ronHartikka/leaf_inverter_rotation/docs/rotation_budget.md

# Rotation budget — the make-or-break question

The whole project turns on one inequality: with 3 loads sharing one inverter
one-at-a-time, the **sum of their duty cycles must stay well under 100%**. If it
doesn't, no rotation schedule can keep all three adequately powered.

## Measured so far

| Load | Running current | Duty cycle | Warmup (OFF)  | Status |
|---|---|---|---|---|
| Dorm fridge | ~0.68 A | ~50% | ~1.1 °F/min | done (test piece, worst case) |
| Chest freezer  | ~0.72 A | ~70% / **60.8%** | ~0.18 °F/min  | done — **flagged for replacement**; see the deployment measurement below |
| Kitchen fridge | ~0.75 A (meas.) | ~60% / **46.9% settled** | TBD (×2 compartments) | night baseline done; deployment measurement below |
| Furnace | TBD | TBD | TBD | later |

**Kitchen fridge — the duty figure swings 13 points on defrost timing [2026-09-28/29].**
A gap-free 17.6 h capture, 17 cycles, one complete defrost
(`firmware/esp32_ads1115_cycle_stats`; see `loads/kitchen_fridge.json`
`deployment_2026_09_28`).

- **Settled cycling 46.9%** (on 24.8, off 28.0 min, sd 0.8/1.6) — the quiet overnight
  state after recovery.
- **Whole capture 59.9%**, including one defrost and its 131 min recovery run at 94.9%
  duty.
- The July night baseline of ~59-60% matches the WHOLE-CAPTURE figure, which suggests
  that window contained a defrost as well.

**So this load has no single duty number.** Defrost fires on accumulated compressor
run-hours (7–50), making it a scheduling term rather than a constant — and the budget
has to treat it as one. Settled on/off (24.8/28.0) also differ from July's ~32/~21 in
opposite directions, so conditions differed too; the two are not mergeable.

**Chest freezer — DEPLOYMENT duty measured 60.8%, not 70% [2026-09-27/28].** A gap-free
13.2 h capture in the deployment location, undisturbed, 9 complete cycles
(`firmware/esp32_ads1115_cycle_stats`, see `loads/chest_freezer.json`
`deployment_cycle_2026_09_28`). Extraordinarily repeatable: **off-period sd 9 seconds**
across 8 intervals, duty sd 0.9%.

- **on 52.3 min, off 33.8 min, duty 60.8%** — against 26.6 / 11.1 / 70% from the
  warm-bench characterisation. Both measured; NOT the same situation.
- The table above now carries both figures. **Which one this budget should use is an open
  decision.** 60.8% materially changes the arithmetic — 3 × 60.8% = 182% rather than 210%,
  still far over budget, but the freezer is less dominant than recorded.
- **It is a PRE-DEFROST number.** Ron observed more frost than usual on 2026-09-26, and
  the doubled run times are consistent with reduced cooling capacity. The queued defrost
  experiment (`docs/todo.md`) uses this capture as its BEFORE half and may move the figure
  again. Settle the budget figure after that, not before.

**Kitchen fridge — night baseline measured [2026-07-21/22 fresh capture].**
~15 h continuous capture with the 3.5 A firmware; clean cycling, no false trips.
- Running current: variable-speed inverter — **~0.75 A steady** near setpoint,
  **~1.5 A during pulldown/recovery** (warm box, e.g. post-defrost).
- **Duty ~59-60%** over 11 h of overnight steady cycling (12 clean cycles: ON mean
  ~32 min, OFF mean ~21 min). Consistent with the 2026-07-19/20 shakedown's ~64%
  eyeball -> the fridge settles around ~60%.
- Freezer band ~-6 to ~+4-5 °F; food-safe throughout. (Per-compartment warmup rate
  + exact band: finalize after the daytime capture, on the full file.)
- Defrost characterized: ~29 min, ~1.8 A / 198 W, sensor-based adaptive. See
  loads/kitchen_fridge.json "defrost".
- STILL NIGHT-ONLY / "pre-stabilized": undisturbed, few door openings, night
  ambient. DAYTIME capture (running till 10pm 2026-07-22) will add the
  higher-duty, doors-open, warmer-ambient regime that reflects real use. Finalize
  day-vs-night duty + per-compartment thermal after that. ~60% is the night floor;
  daytime will likely be higher.

A ~60% fridge is freezer-territory duty and, on its own, hostile to a naive
3-load budget. But see "The real question" below — additive free-running duties
are NOT how this system will actually be scheduled.

## Where this stands
Dorm fridge (~50%) + chest freezer (~70%) already sum past 100% — but the dorm
fridge is a test piece and the freezer is being replaced, so neither is a final
deployment number. The real budget is: **kitchen fridge + replacement freezer +
furnace.** The fridge duty is the next input. A replacement freezer should land far
below 70% (the current unit's high duty is a low-charge/frost fault, not inherent to
chest freezers — its warmup rate proves the thermal mass is excellent).

Michigan outages are cold-weather events, so real-world duty runs below warm-bench
numbers — a tailwind, but don't rely on it to rescue a marginal budget.

## The real question — freezer duty UNDER INTERRUPTION is the gating unknown [2026-07-22]

The tempting arithmetic: fridge ~60% duty -> ~24 min/hr of free inverter time
(measured OFF windows 18-32 min, mean 21). Could the freezer live in that gap?
- Current (faulty) freezer ~70% duty needs ~42 min/hr -> takes ALL the offered gap
  and still falls behind. Doesn't fit.
- A healthy replacement (expected ~20-35%) needs ~12-21 min/hr -> the gap covers it
  with margin. Fits.
So the answer swings ENTIRELY on the replacement freezer's duty — a number we do
not have.

Do we have enough to answer confidently? NO. Three reasons, in priority order:
1. REPLACEMENT FREEZER NOT CHARACTERIZED. The current unit's ~70% is explicitly a
   low-charge/frost FAULT, not the deployment number. This is THE dominant unknown;
   the whole budget pivots on it.
2. FREE-RUNNING DUTY != DUTY UNDER INTERRUPTION. Duty measured under continuous
   power does not directly predict behavior when a box is force-cut for hours
   (recovery is deeper/longer, nonlinearly). Free-running 60%/70% are inputs to a
   guess, not the answer. Only measuring duty IN the interruption regime settles it.
3. REGIME MISMATCH. Intended use is HOURS-on / HOURS-off (not minute-scale
   gap-filling), and in the real system BOTH boxes get interrupted — the fridge will
   not free-run while the freezer sips its gaps. The clean "fridge runs / freezer
   fills gaps" picture does not hold in deployment.

=> NEXT REAL OBJECTIVE: characterize the REPLACEMENT freezer UNDER INTENTIONAL
   INTERRUPTION (simulate the hours-scale rotation blocks the system will actually
   run: power freezer alone, then freezer+fridge). Measuring duty in the deployed
   regime — not more free-running fridge data — is the single measurement that most
   moves the budget toward a confident yes/no. The fridge side is essentially done
   (~60% night baseline; daytime baseline in progress).
   REPLACEMENT FREEZER: not yet ordered (~2026-07-23), going ENERGY STAR for better
   insulation -> expect lower duty + slower warmup (favorable for the budget). Re-
   measure when it arrives; do NOT inherit the old (faulty ~70%) unit's numbers.

INTERIM CHEAP EXPERIMENT (before the freezer, on the fridge already on the rig):
the INTERRUPTION TEST (docs/interruption_test.md) — cut fridge power during a natural
off period for a swept Δt and see when it stays free vs costs recovery. Tests the
central "off-periods are stealable" hypothesis + whether power-cycling disrupts the
run-hours defrost schedule. Yields the max free off-window (a scheduler parameter).

PRACTICAL NOTE — DEFROST LOGIC [confirmed by SERVICE MANUAL + 2 observed defrosts,
2026-07-22]:
- Trigger = COMPRESSOR RUN-HOURS (not wall-clock, not power-on). Manual: defrost
  fires between 7-50 accumulated compressor run-hours, adaptive by door-open time
  (more door-open -> more frost -> sooner). After a true power restore: 4 run-hours.
- Duration terminates when the evaporator defrost SENSOR hits 50 F -> frost-load-
  dependent, ~30 min typical (our 2 defrosts) but up to a 2 h ceiling if heavily frosted.
- Load: ~198 W / ~1.8 A, compressor off, during the window.
Two consequences for the schedule:
  (1) run-hours basis => ROTATION STRETCHES the calendar defrost interval: an
      interrupted fridge accrues run-hours slower, so it defrosts less often per day
      than the ~daily seen at ~60% continuous duty. Favorable — spreads the load.
  (2) after a real outage/restore, the first defrost comes SOON (4 run-hours) => the
      first big fridge power-block after restore should budget a ~30 min defrost early.
Actionable takeaway: budget a recurring defrost window (~30 min typ, up to 2 h), and
expect one early in the first post-restore fridge block. Frequency scales with
door-open activity (daytime > undisturbed night).

ADAPTIVE TRIGGER CONFIRMED FROM DATA [3 defrosts by 2026-07-23]: integrated compressor
run-hours between defrosts were 15.0 (quiet overnight interval, 65% duty) then 8.0
(heavy dinner/evening door activity, 81% duty) -- the threshold slid 15->8 run-hours
toward the 7 h floor as door/frost increased, exactly the manual's "7-50 h by door-open
time." => MILD tailwind only (do NOT bank it): outage door use is somewhat lower, so
defrost is somewhat less frequent -- BUT the household still eats and cooks during
outages [Ron, 2026-07-23], so assume a MODEST reduction, not a large one; do not rely
on defrost being rare. Also: effective fridge duty for budgeting =
~59% steady cycling PLUS periodic defrost+recovery overhead (each defrost adds ~30 min
heater + ~2 h recovery run), which scales with defrost frequency i.e. with use.

## Rule of thumb
- 3 × 50% = 150% → impossible.
- 3 × 15–20% = 45–60% → feasible with margin.

Note ambient temperature with every duty-cycle observation; duty is strongly
ambient-dependent.
