ronHartikka/leaf_inverter_rotation/docs/prior_art_sketches.md

# Prior-art sketches — Nov 2024 to Mar 2025, outside the repo

Surveyed 2026-09-21. **23 Arduino sketches** sit in
`~/Documents/RetirementWork/Engineer/inverter/` on the Mac — the data directory, one
level above this repo — and **none of them are in version control**. They predate the
repo by about eighteen months and several of them are directly relevant to work now
being designed here.

They are NOT copied in, because **10 of the 23 have the live WiFi SSID and password
hard-coded** and this repo is public on GitHub. Anything moved in must first take
credentials from `firmware/shared/wifi_secrets.h` (git-ignored, template in
`wifi_secrets_example.h`).

## The ones that matter

| Sketch | Date | Why it matters |
|---|---|---|
| `continuous_ADS1115` | 2024-12-26 | Interrupt-paced ADS1115 sampling, 860 SPS |
| `nonblocking_ADS1115` | 2024-12-26 | `startADCReading` / `conversionComplete` shape |
| `timer_interrupt_esp32` | 2024-12-26 | ESP32 hardware-timer ISR |
| `rms_ac_with_filters_master` | 2025-01-02 | True-RMS with two-point calibration |
| `running_statistics_socket_server_2` | 2025-02-02 | The convergence: ISR sampling + RMS + socket |
| `esp32_acs712_ads1115` | 2025-03-08 | Bring-up sketch for the §7 perfboard node |
| `socket_server` | 2024-12-20 | ESP8266 — the only ESP8266 network code here |

## Worth reusing

**Interrupt-paced ADS1115 sampling.** `continuous_ADS1115` and
`running_statistics_socket_server_2` already have the correct non-blocking pattern:
`IRAM_ATTR` ISR on ALERT/RDY setting a `volatile bool`, `startADCReading(...,
continuous=true)`, `getLastConversionResults()` in the loop, `RATE_ADS1115_860SPS`.
This is what the ALERT/RDY line on GPIO16 exists for (`docs/mcu_inventory.md` §7).

**`RunningStatistics` from the Filters library.** `inputStats.sigma()` is AC RMS with
DC removed, which is the right measure for an AC current. Note what goes unused:
`inputStats.mean()` is already computing the DC offset — a **live zero** — and every one
of these sketches then ignores it and hard-codes `2.5`. Lesson #4's auto-zero wants
exactly that number.

**Two-point calibration.** `rms_ac_with_filters_master` computes
`Amps_TRMS = intercept + slope * sigma()`. That is the mechanism `mcu_inventory.md` §5
says is mandatory before any ADS1115 number can join the existing dataset.

## Do NOT reuse — the socket half is the wrong shape

Seven sketches implement a `WiFiServer` on port 80. Both of its properties are wrong
for this system:

- **Direction is backwards.** `docs/dual_logger_socket_ingest.md` §2 requires nodes to
  **dial out** to the logger, so the logger never needs to know a node's address and
  DHCP can move nodes freely. These wait to be connected to.
- **They block.** The pattern is `while (client.connected()) { while
  (client.available()>0) {...} delay(5); }`. While a client is connected the sampling
  loop never runs. That is §9's starvation failure by construction — the one measured on
  the RTD node at 41 samples in 122 s where 1 Hz should give ~122.

**Drop the NTP machinery too.** Node-side time is not wanted: §5 arrival-stamps every
line at the logger, and a node clock is a second clock (lesson #8).

The echo loops and the `while(a<9) client.write("a")` counters are demo scaffolding from
whatever tutorial these started as. Nothing to carry over.

## Flags

**The differential arrangement WORKED — it was not merely written.** Corrected
2026-09-23 from Ron's contemporaneous notes (`notes.odt` / `notes2.odt` / `Untitled
6.odt` in the data dir, same text in all three):

> got `continuous_ADS1115.ino` working at maximum rate: `RATE_ADS1115_860SPS`,
> configuration: `ADS1X15_REG_CONFIG_MUX_DIFF_2_3`, mode: `CONTINUOUS`
> attached signal generator 60 Hz, 0 VDC, 1VAC (rms). Got reasonable data to serial
> monitor

So differential AIN2/AIN3 at 860 SPS continuous ran and was **validated against a known
reference** in Dec 2024. What it validated is the ADC and the differential path: 0 VDC
offset means the generator drove the ADC inputs directly, NOT through the ACS712, so the
sensor-to-ADC arrangement is still unproven.

`running_statistics_socket_server_2` (Feb 2025) nonetheless runs
`ADS1X15_REG_CONFIG_MUX_SINGLE_0` with the DIFF_2_3 line commented out. **Why it was
switched back to single-ended is unrecorded.** Decide it deliberately; do not read the
comment-out as evidence that differential failed.

**The signal generator is a reusable asset here.** A known 60 Hz amplitude is exactly
what the §5 cross-calibration against the ACS712 + Arduino chain needs.

**Single-ended reads use a hard-coded 2.5 V zero**, with a commented-out `2.325` from
some earlier bench session sitting next to it — the drift lesson #4's auto-zero window
exists to catch.

## The intended architecture: statistics per POWER CYCLE

The same notes record the design Ron was working toward in Jan 2025, and it is better
than what shipped:

> But to measure at say 600 sps — ten times in each 60 Hz cycle — I don't want
> continuous? ... If 60 Hz sample, output stats for this 60 Hz cycle, reset stats

> Goal for 2 Jan 2025: ... sample window for RunningStatistics is **one power cycle**, if
> possible

One RMS value per 60 Hz cycle, statistics reset every cycle. That yields the **envelope**
of a start transient cycle by cycle, which is what surge work needs.

What actually shipped does the opposite. `running_statistics_socket_server_2` sets
`windowLength = 10/testFrequency` — a ~167 ms window smearing about ten cycles together,
which is precisely what hides a transient. The window values drift across the
collection: 0.8 s in `ACS712_Code_3`, 0.033 s in `rms_ac_with_filters_master`, 0.167 s in
the newest.

**The 50/60 Hz trap, already caught by Ron in the notes:** `ACS712_Code_3` ships
`testFrequency = 50` — a European default — and his note flags it, "Power line frequency
(not in USA, though)". Any sketch inheriting that constant computes its window against
the wrong line frequency.

## An opening on lesson #10

These sample at 860 SPS but keep only `sigma()` over a ~167 ms window, so peaks are
averaged away before anything records them. **A per-window max-hold on the raw samples
would cost nothing and would bound the chest freezer's inrush**, which lesson #10 says
is currently unmeasured and which `docs/jackery_300_plus.md` calls the single strongest
argument for a scope measurement.

At ~14 samples per 60 Hz cycle this still cannot give a true instantaneous peak —
lesson #10's conclusion is unchanged — but it would move that number from "unmeasured"
to "bounded", and unlike a scope it can sit for days waiting for a cold start.

## What this does NOT answer

`socket_server` proves basic ESP8266 connect works (`ESP8266WiFi.h`, `WiFi.begin`,
`WiFi.status`, `localIP`). It does **not** close the open item in
`docs/wifi_bridge_build.md`: nothing here does best-AP-by-signal, WiFi event handlers,
or BSSID logging, so the ESP32→ESP8266 translation of `docs/esp32_wifi_production.md`
is still unanswered.

## The board's purpose, and the one capture that survives

Ron's recollection (2026-09-21): the §7 perfboard node was built **to measure surges**,
with the furnace blower and the compressors as the targets. A large fan was measured
with it.

That capture still exists: `CoolTerm Capture (Untitled_0) 2025-03-09 11-46-54-590.txt`
in the data dir, 5426 samples, opening with `Getting single-ended readings from
AIN0..3` — the banner of `esp32_acs712_ads1115.ino`, dated the day before. Values are
volts (the sketch prints `volts0` raw).

| | volts | amps @ 100 mV/A |
|---|---|---|
| min | 1.47 | −8.0 |
| max | 3.06 | +7.9 |
| mean / median | 2.2698 / 2.27 | — |

The chain worked: a symmetric ±8 A peak AC waveform, sampled on the waveform itself
rather than as an RMS.

### Three findings from it, all blocking for surge work

**PROVENANCE (Ron, 2026-09-21): this capture was probably made with the BREADBOARD
version, which no longer exists.** The perfboard node "probably" carries the same
wiring, but that is recollection, not verification — it cannot be used to validate the
perfboard board. Practical consequence: **do not inherit the 2.27 V zero below.** A zero
belongs to a specific sensor on a specific supply, not to a design. Re-measure it on the
finished board. What survives is the *shape* of the finding, which is architectural.

**1. The measured zero is 2.27 V, not 2.5 V.** Every sketch computes
`(volts0 - 2.5) / 0.100`, so everything that chain ever reported carries a systematic
**−2.3 A** offset. The commented-out `2.325` sitting beside it was chasing the same
thing. And 2.27 V is **below the 2.3–2.7 V auto-zero window** in
`firmware/shared/current_sense.h` — lesson #4's sanity check would REJECT this sensor.
Resolve that before quoting any number off this board; `inputStats.mean()` already
computes a live zero and is being thrown away.

**2. `GAIN_ONE` clips at ~16 A, which is the wrong ceiling for surge work.** At
±4.096 V full scale against a 2.5 V zero, `(4.096 − 2.5) / 0.1 ≈ 16 A`. Lesson #10 says
the chest freezer's true inrush is unmeasured and likely well above the method-limited
~3.5 A, so GAIN_ONE risks truncating the very number the board exists to capture. Use
**`GAIN_TWOTHIRDS`** (±6.144 V), which several sketches carry commented out.

**TRAP — the gain comment is wrong in five sketches.** They read
`ads.setGain(GAIN_ONE);  // 2/3x gain +/- 6.144V`. The comment describes a DIFFERENT
gain than the code sets. Anyone reading it believes they have 6.144 V of range when
they have 4.096.

**2b. The ADS1115 is NOT ratiometric, and that is the real lesson here.** The ACS712's
zero is **Vcc/2 by design**, so a 2.27 V zero implies a sensor rail near **4.54 V** —
230 mV is far outside ACS712 offset tolerance, so this reads as a sagging supply, not a
quirky part. (Reasoned from the capture, not separately measured — mark it medium
confidence until the finished board is checked.)

The ADS1115 has an internal precision reference and its FSR settings are absolute volts,
which is why `computeVolts()` returns volts rather than a ratio. The rig's Arduino gets
supply cancellation **for free** because its ADC reference IS the 5 V rail the ACS712
runs on, so sag moves sensor and reference together. An ADS1115 throws that away: a
sagging sensor rail moves the zero AND the sensitivity, straight into the reading.

Two consequences:

- **§5's differential-against-Vcc/2 is not a refinement, it is the fix** — it cancels
  supply drift in hardware and restores what this architecture otherwise loses. The
  parked `readADC_Differential_2_3` code is the thing to revive.
- **The 9 V → 7805 supply concern gets sharper.** A battery-fed regulator sagging under
  ESP32 WiFi bursts does not merely risk corrupt reads; in single-ended mode it silently
  moves the calibration.

**CHECK ON THE BOARD:** how AIN2 and AIN3 are actually wired decides whether differential
mode is available as built. Add it to the continuity check in `mcu_inventory.md` §7.

**3. The capture is free-running and unpaced** — `Serial.println` in a bare loop, no
timestamps, no fixed rate. It gives amplitude only; a start transient cannot be told
from running current in it. That is exactly what the interrupt-paced 860 SPS path in
`continuous_ADS1115` fixes, and why the board should be finished on that path rather
than this one.

### Why the targets are the right ones

`loads/furnace.json` carries **every** electrical value at `confidence: low`, cube-law
derived, none measured — the blower is genuinely unmeasured rather than imprecise. And
the freezer compressor is lesson #10's open item. Both are the gap this board was built
for, and neither is served by the rig's 10 Hz / 100 ms-RMS chain.
