ronHartikka/leaf_inverter_rotation/analysis/coast_setting5_0727eve.png

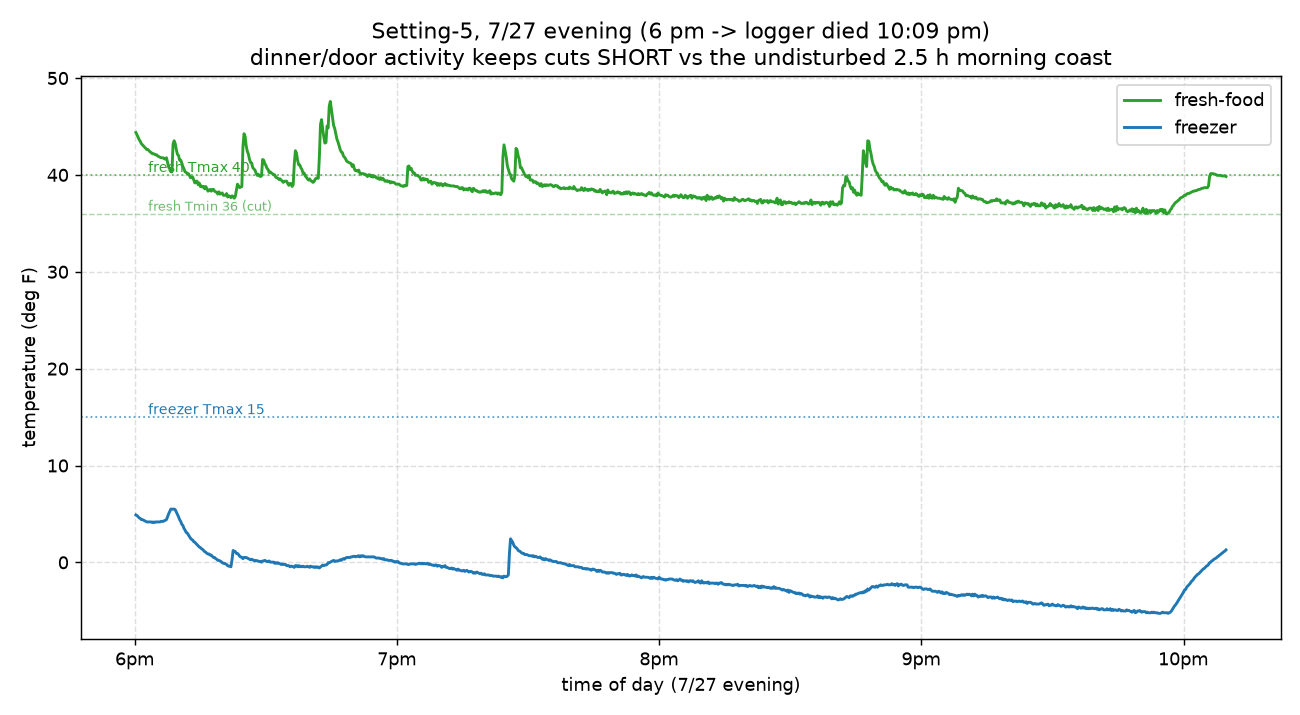
analysis/coast_setting5_0727eve.png
