ronHartikka/leaf_inverter_rotation/analysis/coast_setting5_0728.png

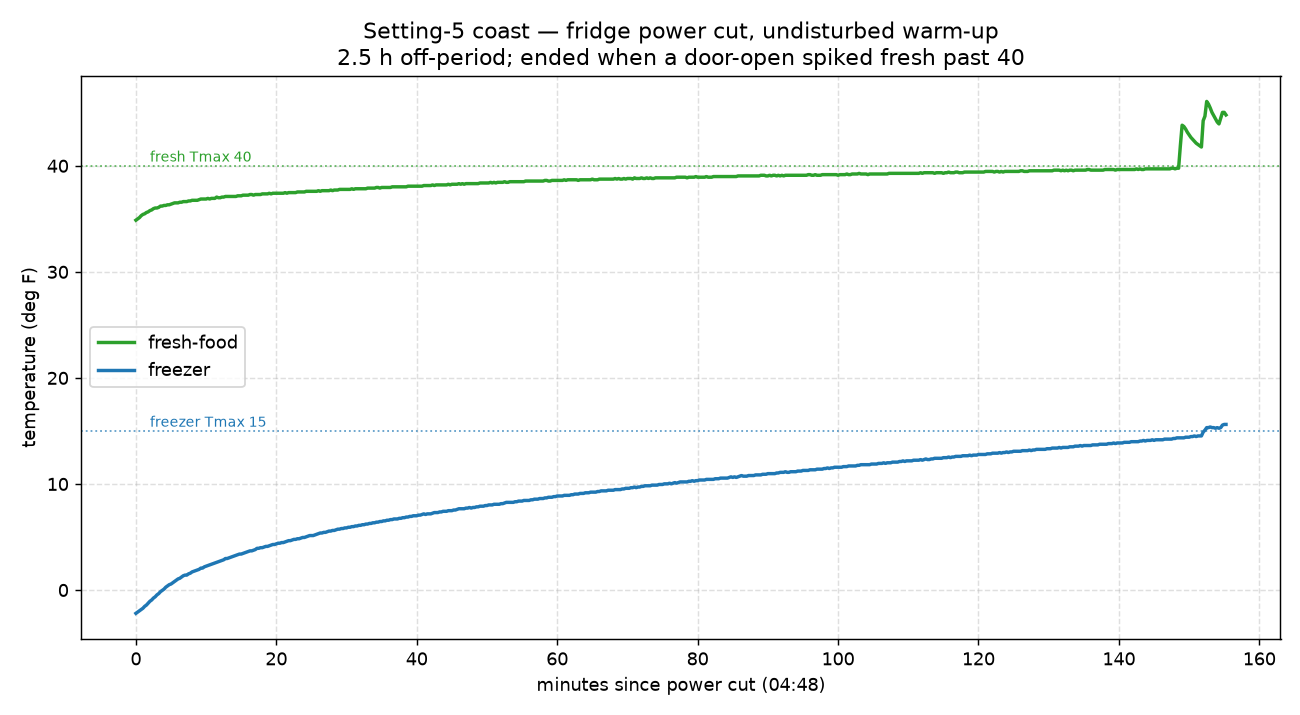
analysis/coast_setting5_0728.png
