ronHartikka/leaf_inverter_rotation/analysis/demand_profile.png

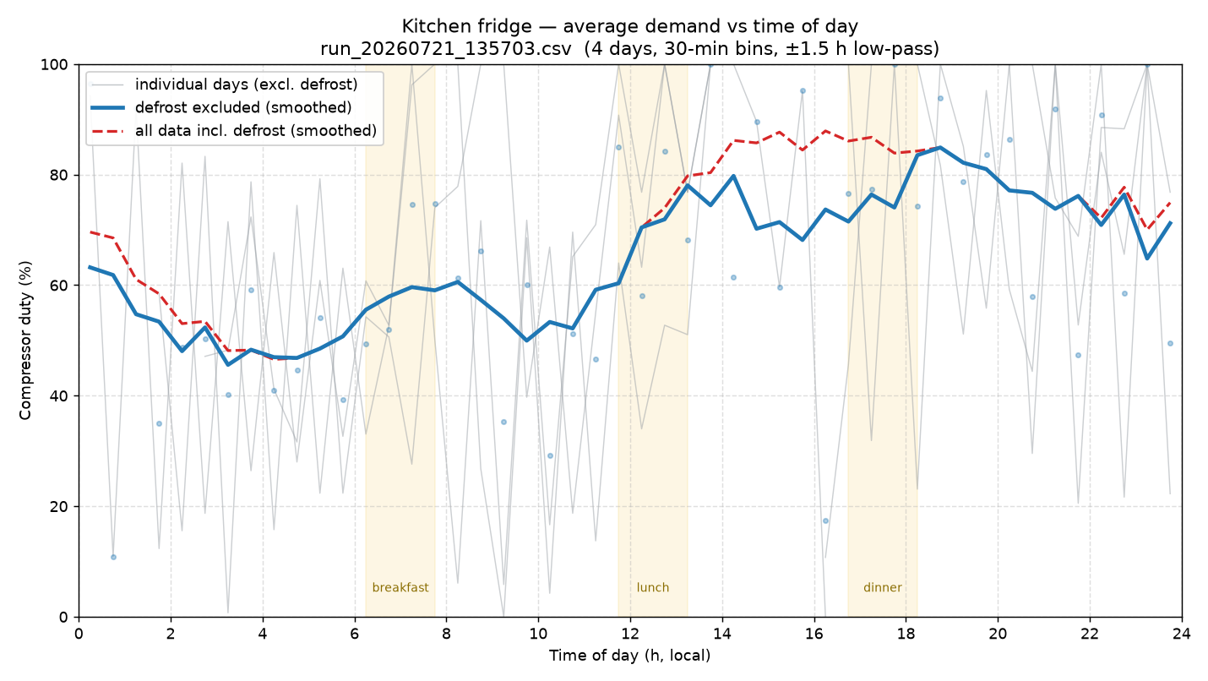
analysis/demand_profile.png
