ronHartikka/leaf_inverter_rotation/analysis/ffc_control_law.png

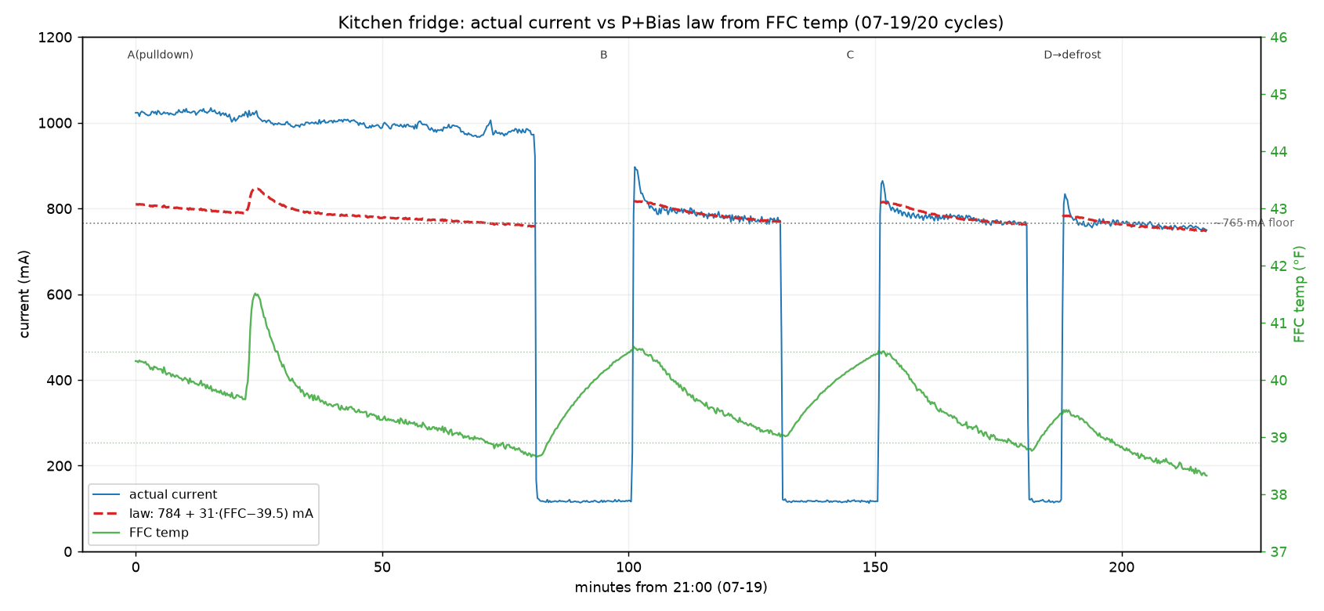
analysis/ffc_control_law.png
