ronHartikka/leaf_inverter_rotation/images/IMG_7952.jpeg

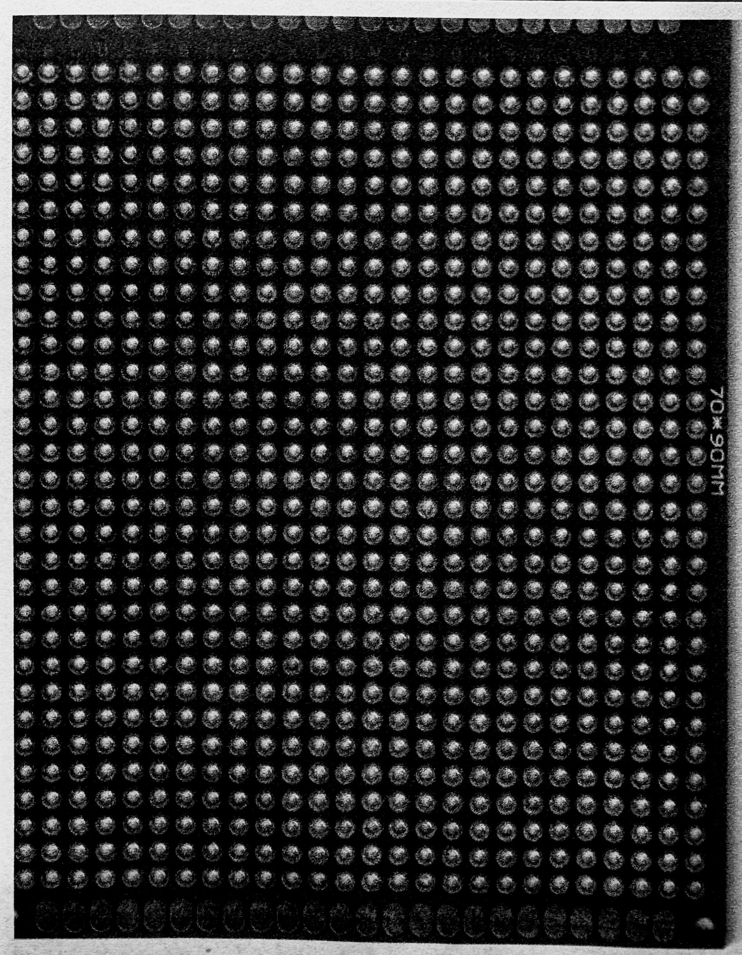
images/IMG_7952.jpeg
