ronHartikka/leaf_inverter_rotation/(commit log)

2026-07-19 Add handover backlog + kickoff prompt; land real dual_logger.py
    - docs/todo.md: prioritized backlog (P0 PT1000 sub-zero conversion fix and
    the keep-resistance architecture decision, P1 column-rename header change,
    P2 kitchen fridge characterization, P3 hygiene, production firmware)
    - docs/claude_code_kickoff.md: first-session prompt pointing at the docs
    - tools/dual_logger.py: replace placeholder stub with the real logger from Ubuntu
    - README: link the two new docs
    [dual_logger.py]
2026-07-19 Add ESP32 RTD sketch to repo; sharpen P0 cross-check to three-way
    - firmware/esp32_rtd_display/: the real ESP32 MAX31865 sketch (2x PT1000,
    display). Serial stream carries both Resistance and Temperature(F); confirms
    dual_logger parses Resistance and reconverts.
    - docs/todo.md P0: cross-check must be three-way (ESP32 F vs dual_logger F vs
    independent PT1000 reference) — older Adafruit lib shares the same sub-zero
    bug, so agreement != correct. Check installed lib version too.
    [ESP_WROOM_32_096_Adafruit_MAX31865_x2.ino]
2026-07-20 Confirm root cause: overnight overcurrent latch, defrost-heater hypothesis
2026-07-20 P0 PT1000 sub-zero fix + verify; kitchen-fridge overcurrent firmware fix
    Logger (tools/dual_logger.py):
    - res_to_c(): add the sub-zero Callendar-Van Dusen branch (Newton on the exact
    both-branch forward CVD, seam at R0). Self-contained; no header/consumer change.
    - --self-test: pin conversion to 9 IEC 60751 PT1000 points, both branches
    (PASS, worst 0.0013 C). Measured old-vs-fixed delta is <0.005 F in the
    fridge/freezer range, so archived data is effectively unchanged (recompute is
    now cosmetic).
    - Never clobber an existing capture: exclusive-create the CSV + .raw, refuse if
    either exists (replaces silent append mode).
    Cross-check (tools/crosscheck_temps.py, new): three-way logger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
    [characterize_load.ino, crosscheck_temps.py, dual_logger.py]
2026-07-21 Overcurrent trip 3.0->3.5A (nameplate-anchored); kitchen_fridge.json; defrost design notes
    Firmware (characterize_load.ino): raise OVERCURRENT_A 3.0 -> 3.5 A. Anchor is the
    interior nameplate whole-unit rating 115 V / 2.7 A max -- the unit never
    legitimately draws above 2.7 A in any mode incl. defrost (observed ~2.4 A entry
    peak sits under it), so 3.5 A is ~30% over the rated ceiling: no false-trip on
    rated-normal operation, still catches a genuine hard stall. Compiles clean.
    loads/kitchen_fridge.json: build from schema with AUTHORITATIVE nameplate
    (LTCS20020B, 115 V/2.7 A max, 198 W defrost, R600a 62 g, 2022-11, Mexico) and the
    DECIDED firmware constants (3.5 A trip, 20 s debounce, 180 s m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
    [characterize_load.ino]
2026-07-21 Logger robustness (port auto-detect, timestamped out, reconnect self-heal) + rig checklist
    dual_logger.py -- kill the recurring "won't connect / wrong port" startup pain:
    - auto-detect ports by USB vendor id (Arduino=current, ESP32 bridge=temps), so
    ttyACM0<->1 / ttyUSB0<->1 renumbering no longer points it at the wrong device.
    --current-port/--temp-port still override; --list-ports to see what's attached.
    - timestamped default --out (run_YYYYmmdd_HHMMSS.csv) so a forgotten or replayed
    command can't clobber an existing capture -- it just makes a fresh file.
    - reconnect self-heal: both streams share one connect/re-resolve generator; if a
    device drops (esp. the flaky breadboard ESP32) t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
    [dual_logger.py]
2026-07-21 Record live kitchen-fridge defrost + recovery findings (2026-07-21 capture)
    From watching the fresh-capture power-up in real time (fridge went straight to
    defrost on power-up):
    loads/kitchen_fridge.json:
    - new "defrost" block: sensor-based adaptive (thermistor-terminated); flat
    ~1.8 A / 198 W heater (compressor OFF, confirmed by observation + drain-pan
    melt water); ~29 min duration = the min uninterrupted window; periodic ~10-min
    measurement dips to ~1 A (detector must debounce); post-defrost peak 24 F /
    41 F; ~7 min dwell; ~1.5 A high-speed pulldown tapering to ~0.75 A.
    - running_current noted as variable-speed (~0.75 A steady / ~1.5 A pulldown).
    - probe->compartment->column mappin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
2026-07-22 Kitchen fridge night baseline (~59% duty) + freezer-under-interruption as the gating unknown
    From the 2026-07-21/22 fresh capture (~15 h, 3.5 A firmware, no false trips):
    - Duty ~59-60% over 11 h of overnight steady cycling (12 clean cycles, ON ~32 min /
    OFF ~21 min) -- the fridge settles ~60%. Running current ~0.75 A steady / ~1.5 A
    pulldown (variable-speed inverter). No 2nd defrost overnight.
    - Marked NIGHT-ONLY / pre-stabilized; daytime capture running till 10pm 2026-07-22
    to add the doors-open, warmer-ambient (realistic-use) regime. Per-compartment
    warmup + thermostat band to be finalized on the full day+night file.
    Strategic conclusion recorded in rotation_budget.md ("The real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
2026-07-23 2nd defrost observed -> defrost is autonomous (~daily), not power-on-triggered
    A 2nd defrost fired mid-run 2026-07-22 13:55-14:26 (30.4 min, ~1.87 A / 198 W,
    compressor off, freezer -6.6->+22 F) with NO power cycle, ~23.5 h after the first
    (~13-14 compressor run-hours at ~60% duty). Resolves the earlier open question:
    - Defrost is AUTONOMOUS / self-scheduled (~once per day), NOT power-on-triggered.
    The immediate defrost on power-up was just an overdue one firing at restore.
    - Duration is repeatable: both defrosts ~30 min, freezer peak ~+22-24 F.
    - Budget impact: rotation must expect a RECURRING ~daily ~30 min / 198 W defrost
    window (autonomous), on top of any defrost at power-restore --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
2026-07-23 Defrost logic confirmed by service manual: run-hours based, sensor-terminated
    Manual defrost spec (Ron) reconciled with our 2 observed defrosts:
    - Trigger = compressor RUN-HOURS (7-50 h, adaptive by door-open time), NOT
    wall-clock/power-on. After a true power restore: 4 run-hours. Our 2nd defrost at
    ~13-14 run-hours is in-band; the immediate 7/21 plug-in defrost was an overdue
    counter (3-min unplug didn't reset run-hours), not a fresh power-on count.
    - Duration terminates when the evaporator defrost sensor hits 50 F (2 h malfunction
    ceiling) -> frost-load-dependent: ~30 min typical (our two), up to 2 h worst case.
    Corrects the earlier "fixed ~30 min". The 50 F is the evaporator sen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
2026-07-23 Post-defrost recovery ~2h -> protected window = defrost + recovery ~2.5h (strategy)
    Measured on the clean 2nd defrost (2026-07-22): after defrost end (freezer +17 F,
    peaked +22 F) the compressor ran CONTINUOUSLY ~2 h (14:26 -> first shutoff 16:26) to
    pull back to the -3.6 F cut-out; full return to steady ~0.8 A cycling ~4.5 h.
    Ron's strategy point, now quantified: cutting the fridge right after a defrost warms
    the box from its warmest, un-recovered point (food-safety risk). RULE: once a defrost
    is detected, protect through defrost AND the ~2 h recovery before the fridge is
    eligible to be cut for rotation. Extends the min-uninterrupted-window from ~30 min to
    ~2.5 h when a defrost is in play.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
2026-07-23 Add interruption-test protocol; record Energy Star replacement-freezer decision
    docs/interruption_test.md (new): planned protocol for the cheap high-value experiment
    on the fridge already on the rig -- cut power during a natural off period for a swept
    Δt (~5/15/30/60/120 min) and find where stealing the window is FREE (compressor stays
    off on restore) vs where it costs recovery run-time. Framed as "two clocks": the
    thermostat (kink at the ~21 min natural off-period = max free off-window, the key
    scheduler parameter) and the control-board counters (does power-cycling re-arm the
    4-h-after-restore defrost / reset run-hours? -- 3-min unplug is known NOT to). Includes
    preconditions, sweep proced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
2026-07-23 Temper the outage/defrost tailwind: modest door reduction, not 'rare'
    Ron correction (2026-07-23): the household still eats and cooks during outages, so
    door openings drop only MODESTLY, not dramatically. Walk back the earlier "defrost
    becomes RARE during outages" claim -> mild tailwind at most; do not bank it (per the
    existing "don't lean on tailwinds to rescue a marginal budget" rule). Defrost
    frequency does track door use, but assume outage frequency ~similar to observed,
    maybe a bit less.
    (Also noted in memory: replacement freezer is >1 month out via Costco, so the
    interruption test is the near-term work.)
2026-07-23 Expand interruption test: two off-window concepts + Part B outage-config coast experiments
    Clarify FREE window (~20 min, steal the natural idle gap at zero cost -- fine-grained
    rotation) vs SAFE window (hours, coast to the 40 F food-safety line accepting recovery --
    the binding number for hours-scale rotation, Ron's intended use).
    - Part A = the existing Δt sweep (measures the free window).
    - Part B (new) = outage-config coast experiments measuring COAST-TO-SAFETY per compartment
    across 4 configs: baseline (3/5 lights) / colder (4/5 lights) / +ice blocks / both.
    Idea 1 (colder setpoint) is a TRADE: longer coast for higher steady duty -- record both.
    Idea 2 (ice blocks, "= 7 lb ice" e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
2026-07-23 Decide Tmax abort thresholds (fresh 42F / freezer 19F) + food-simulant probe
    Tmax on our AIR RTDs, anchored to the fridge's OWN manufacturer-safe defrost air peaks
    (fresh routinely ~40-42F, freezer ~16-19F every defrost, x4 observed):
    - Tmax_fresh = 42 F (room above the ~37F setpoint; food lags air so 42F air != food >40F)
    - Tmax_freezer = 19 F (also keeps food well frozen / below thaw -> protects quality)
    Caveat: the air-leads-food margin shrinks on hours-scale coasts -> validate with a
    FOOD-SIMULANT probe (RTD in a water bottle / ice block) added to the Part B coast runs,
    which maps air-vs-food temp directly. Do NOT map our air RTDs to the fridge's evaporator
    COIL defrost sensor (different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
2026-07-23 P2+ record: demand-aware dispatch control architecture ("New Thinking")
    Ron's architecture shift (2026-07-23): supersede blind round-robin offering with
    demand-aware dispatch. Monitor ALL temps continuously (fridge x2, chest freezer,
    freezer, house, outdoor) so demand is KNOWN, not probed -> offer power only when a
    load's temp says it needs it (no wasted offers/refusals).
    Consequences recorded: (1) temp telemetry promoted from enhancement to the spine of
    control (makes the ESP32->Arduino link central); (2) abort-on-Tmax safety law -- watch
    both fridge compartments during an off-period, restore on either crossing Tmax (fresh
    42F / freezer 19F), hold until recovered; shorter-coasting compartm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
2026-07-24 Fridge characterization closed: fill thermal + all-in duty from 74.3 h run
    74.3 h continuous capture (run_20260721_135703.csv, 2026-07-21..24) analyzed
    per compartment via characterize.py -> loads/kitchen_fridge.json:
    - duty: ~59% steady + 68.4% all-in (adds 4 defrost+recovery cycles + daytime doors)
    - bands: freezer -4.3/+5.8 F (10.1); fresh-food 35.3/40.1 F (4.8)
    - warmup/pulldown per compartment; warmup carries a short-timescale/non-linear
    caveat (do NOT extrapolate to Part-B hours-scale coasts)
    characterize.py: add opt-in --temp-min/--temp-max sanity filter so an RTD bump
    (t2 -> -207 F, 7/24, fault flag missed it) or door spike can't pollute the
    envelope/slopes. Fresh-food numbers com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
2026-07-26 analysis: add demand-vs-time-of-day profile (demand_profile.py + PNG)
    Bins a dual_logger capture by time-of-day (30-min) and plots raw vs
    DEFROST-EXCLUDED duty with a +/-1.5 h circular low-pass and faint per-day
    traces (so a one-off restock shows as an outlier day). On the 74 h file:
    overnight trough ~46% at 3-4 am, peak at the dinner hours (~17:30-18:30),
    breakfast/lunch lesser bumps. Removing defrost (run-hours-based, clusters in
    afternoons this capture) shifts the apparent peak off mid-afternoon onto
    dinner -- the real activity peak.
2026-07-26 live_chart: fixed round-number dual axes with aligned gridlines
    Both y-axes fixed (no autoscale): temperature -10..70 F step 4, current
    0..2000 mA step 100 -- equal tick counts, so each horizontal gridline meets
    a round value on BOTH scales. Current plotted x1000 as mA.
    [live_chart.py]
2026-07-26 dual_logger: add --coast-control (automated cut/restore) + timer test mode
    Opt-in coast control (default OFF; pure logging unchanged). Holds the load's
    power OFF by DTR-resetting the Arduino faster than its ~180s relay hold-off;
    RESTORE = stop resetting -> Arduino closes the relay itself. Fail-safe by
    construction: any failure (thread/logger/temp-feed death, Ctrl-C) stops the
    resets and power returns within the hold-off. Guards force power on: hit-Tmax
    (either compartment), temp STALENESS (keyed off a new temp_updated_at, not the
    sample-and-held value that would mask a hung sensor), and a hard max-off cap.
    --coast-test-timer: sensor-independent cut/restore on a fixed clock, to validate
    the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
    [dual_logger.py]
2026-07-30 dual_logger: add relay_cmd, current_stale, compressor_on status columns
    The sample-and-hold merge silently repeats the last current value when the
    Arduino stops reporting -- during a coast cut (Arduino held in reset) or a
    plain sensor/comm dropout -- so a 24 h coast run read as ~94% "on" from the
    current line while the box actually drifted to +27/+51 F. The .coast event
    log had the truth, but out-of-band from the per-sample CSV.
    Fold that state into every row as three status bits:
    relay_cmd commanded load power (coast FSM: 1=POWERED, 0=CUT; 1 when
    coast is off). Authoritative intent, no inference.
    current_stale current value older than CUR_STALE_S (3 s) -> held/froze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
    [dual_logger.py]
2026-07-30 Add root CLAUDE.md: loads guardrails + invariants every session
    Imports docs/lessons.md so the hard-won lessons enter context automatically
    rather than depending on a manual kickoff paste. States production-firmware
    invariants (watchdog, non-blocking millis, safe startup, min-off across
    resets) as rules, plus repo conventions and working style.
2026-07-30 Recover ESP32 WiFi production notes from 2026-07-28 chat
    Best-AP selection (scan/sort method — validated, basement node chose Buffalo
    at -42 dBm), disconnect reporting via WiFi event handler, no-roam caveat and
    optional RSSI-triggered reconnect, heartbeat vs disconnect-log coverage, boot
    banner, strapping-pin node identity, Buffalo barrel-jack repair note.
    Never crossed from chat to repo when originally written.
2026-07-30 CLAUDE.md: point at docs/esp32_wifi_production.md
2026-08-01 dual_logger: reject corrupted CUR serial lines (false 0.000 A fix)
    Occasional current-channel serial lines arrive garbled on the USB link (bytes
    corrupt in transit; the Arduino's value and the t_ms are fine). The old lenient
    prefix regex parsed a garbled "38906058,0)<junk>" as amps="0" -> a false 0.000 A,
    clustering as current levels off near setpoint (likely inverter-PWM EMI on that
    lead). current_stale can't catch these -- a corrupt line is fresh, just wrong.
    Harden the parser to an end-anchored, decimal-required match:
    ^\s*(\d+),(\d+\.\d+),(\w*)\s*$
    Corrupted lines now fail to match and are dropped (the merge holds the prior value,
    a ~250 ms gap, well under the current_stale threshold)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
    [dual_logger.py]
2026-08-01 lab_notebook: add append-only change log + tiny local logging app
    Physical events the data can't record on its own (dial settings, cold-packs in/out,
    door-heavy days, defrosts, hardware swaps) kept getting lost, which is what limits
    confidence in the night-to-night comparisons. Add docs/lab_notebook.md (append-only,
    seeded with the known events + UNKNOWN flags for the FFC 3->5 date and cold-pack
    dates) plus tools/lab_notebook_app.py: a stdlib-only localhost app (text box + Add
    button) that appends a timestamped line and shows the entries as a Date/Time/Entry
    table. No dependencies; the .md file stays the source of truth.
    [lab_notebook_app.py]
2026-08-01 lab_notebook: reconstruct FFC 3->5 date (~Jul 21 13:57)
    FFC free-cycle band shifted ~5 F colder across the file boundary (Jul 19-20 run cut
    out ~39 F, Jul 22 & 24 cut out ~34 F; both non-coast). Colder cut-out = colder
    setpoint = the 3->5 change, and cut-out temp is ambient-independent. Pinned to the
    start of run_20260721_135703, bracketed to the [Jul 20 07:32 - Jul 21 13:59] gap.
2026-08-01 firmware: add esp32_rtd_serial_check (serial-only RTD verify for new board)
    Step 1 of the ESP32 RTD WiFi migration: read 2x PT1000 (MAX31865, software SPI,
    same pins as esp32_rtd_display) and print resistance/temp/fault over USB serial in
    the format dual_logger already parses. No display, no WiFi. Verified on the new
    WROOM-32: both channels ~1099 ohm / ~78 F, matched within 0.3 F, no faults.
    Current-sensing path (Arduino->USB->ubuntu) is unchanged; this node is temps-only.
2026-08-02 tools: add clean_window_duty.py (defrost-free per-night duty scorer)
    Fixed 00:00-06:30 duty was biased high whenever a defrost's recovery run landed in
    the window. This scores each night over the longest defrost-free span instead:
    detect the ~1.9 A defrost heater (bridging the coil-sampling dips), searching from
    the prior evening so a pre-midnight defrost's recovery is caught; exclude
    defrost+recovery (recovery ends at the first coast after it); take the longest clean
    span in 00:00-07:00, trim to 5 h; report duty there. Same rule every night.
    Re-scored (all FFC=5): FC=1 -> 35/41/42% (mean ~39%, 3 nights); FC=3 -> 44% (1 clean
    night). FC=1 still lower; needs more clean FC=3 nights. Notebook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
    [clean_window_duty.py]
2026-08-02 firmware: add esp32_rtd_node -- production temp node (RTD + OLED + WiFi + ID)
    The kitchen-fridge substitution module. Reads 2x PT1000 (MAX31865, software SPI) and
    prints them over USB in dual_logger's format (data path stays USB), shows both temps
    on the OLED (freezer on top), brings up WiFi non-blocking with best-AP select + AP
    report (idle for now -- USB carries the data), and reads strapping ID pins at boot.
    CS pins mapped so freezer -> channel 1 (t1_freezer), confirmed by co-located
    comparison vs the old module (matched within ~0.1 F). WiFi creds are placeholders.
    Deployed on the FC=3 run 2026-08-02.
2026-08-02 lab_notebook: log the power lesson and the FC 1->3 + temp-module-swap transition
2026-08-03 tools: native free-cycle scanner + scrubbable run viewer
    free_cycle_scan.py: find where the fridge shut its own compressor off while
    our controller had power applied. Distinguishes the three states from the
    current signal (frozen=our coast, noisy-low=native off, running), honors the
    current_stale flag on 12-col runs, and tags each event running- vs coast-
    preceded. Used to separate real fridge cutoffs (5 confirmed: Jul 27 x4 in
    run_auto_0726_2007, Aug 3 03:53 in run_auto_0802_1649) from ~7-min-at-40F
    sensor dropouts.
    scrub_run.sh + scrub_chart.py: offline pan/zoom viewer for any run_auto*.csv on
    the Ubuntu box (companion to watch_run.sh/live_chart.py). Span default 10h with
    +/-1h; start def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
2026-08-04 tools: add fridge_compressor_stops.py + lab_notebook findings
    fridge_compressor_stops.py: find where the fridge's own controller stopped a
    running compressor (relay closed, current fresh, non-defrost); report the FFC
    temp at the stop and the off-duration. Handles 9-col (no-relay-control) and
    12-col runs. Used to characterize the fridge's compressor-off temp (~35 F,
    tight) and off-duration (median ~23 min, no 7-min floor).
    lab_notebook: 7-min wait is a power-on delay (corrected); current-channel
    dropout/EMI correlation; Aug 3-4 duty; compressor-cycling characterization and
    the rotation insight (ride natural off windows, don't coast for its own sake).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
    [fridge_compressor_stops.py]
2026-08-04 firmware: add esp32_rtd_wifi_test (WiFi TCP-stream reference)
    The throwaway connectivity test that proved ESP32 -> WiFi -> TCP -> host listener
    (2026-08-01). Kept as the reference for the deferred WiFi-cutover + socket-ingest
    work, since production esp32_rtd_node does WiFi connectivity-proving only, no TCP.
    Creds are placeholders; HOST is a LAN IP.
2026-08-04 analysis + images: coast/demand plots and rig photo
    analysis/*.png: coast setting-5 plots (0727 eve, 0728) + demand profile.
    images/: rig photo (IMG_7952.jpeg) + its GIMP source (.xcf). No GPS/location
    metadata; EXIF is device model + timestamp only.
2026-08-04 data: sample run + scrub_chart.py file-path option
    data/sample_run_auto.csv: 8 h / 1 Hz slice of run_auto_0802_1649 (Aug 2 21:00 ->
    Aug 3 05:00), 12-col, ~2.3 MB, with a defrost, relay-open (coast) spans, and the
    03:53 fridge compressor-stop -- so the viewer tools have something to demo. Just
    sensor time-series, no network/personal data. Allowed past data/.gitignore's
    *.csv via an explicit !sample_run_auto.csv exception.
    scrub_chart.py: accept an optional CSV path arg (else stdin), so a fresh clone
    runs 'python3 tools/scrub_chart.py data/sample_run_auto.csv' with no Ubuntu.
    [sample_run_auto.csv]
2026-08-04 add requirements.txt for the chart/analysis venv (matplotlib/numpy)
    Recreate: python3 -m venv venv && ./venv/bin/pip install -r requirements.txt
    Lets a fresh clone run scrub_chart.py on data/sample_run_auto.csv.
2026-08-10 furnace: expand heating-budget to 5 seasons of DTE gas data
    Commit the DTE daily-gas exports under data/gas/ (2021-01-02..2026-08-08,
    2045 days, 0 gaps) so the furnace heating budget is reproducible from
    committed inputs, and add tools/gas_heating_budget.py which merges them and
    walks every heating season. The 2022-23 season is a self-test against the
    values already stored in furnace.json (PASS).
    Findings folded into loads/furnace.json:
    - duty_cycle now n=5 (mean 0.26, range 0.23-0.29); 2022-23 sits on the mean,
    so the "warm-winter bias" caveat is withdrawn (it was representative).
    - peak_observed revised to the true five-season worst (2025-26, 0.78 4-day
    duty) - the Elliott 2022 snap w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
    [gas_usage_report_01-02-2021_to_08-31-2021.csv, gas_usage_report_06-29-2026_to_08-03-2026.csv, gas_usage_report_08-03-2022_to_09-05-2023.csv, gas_usage_report_09-01-2021_to_08-31-2022.csv, gas_usage_report_09-01-2022_to_08-31-2023.csv, gas_usage_report_09-01-2023_to_08-31-2024.csv, gas_usage_report_09-01-2024_to_08-31-2025.csv, gas_usage_report_09-01-2025_to_08-08-2026.csv]
2026-08-10 fridge: record defrost-entry current profile; note furnace needs its own
    Profile the defrost ENTRY transient in loads/kitchen_fridge.json
    (defrost.entry_transient): a sequenced compressor->heater handoff per the
    service manual's switching order - a staircase peaking ~2.4-2.6 A for ~2 s,
    settling to the ~1.9 A heater-alone steady. Reproducible across two defrosts
    (07-20 comp 0.73A -> 2.38A; 08-08 comp 0.99A -> 2.56A). Dead-flat plateaus
    rule out cold-element inrush; the peak is a VECTOR sum of the lagging
    compressor (PF ~0.55) + resistive heater, not scalar addition (RMS-only data,
    PF inferred, to be confirmed by scope).
    - todo: correct the old single-overlap wording to the sequenced-handoff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
2026-08-11 fridge: record compressor-stop profile + compressor-off idle floor
    From a clean heater-free stop (run_auto_0802_1649.csv, 2026-08-03 03:53):
    - compressor_stop_profile: the inverter drive decelerates in discrete speed
    steps (~747 mA -> ~520 mA held ~4 s -> out), a ~4-5 s event, not an edge.
    This is the same rampdown seen inside the defrost entry, now isolated with
    no heater overlap -> confirms the defrost down-steps are drive deceleration,
    not board load-sequencing.
    - compressor_off_idle_a: the fridge idles at ~120 mA / ~14 W between cycles
    (power still applied), NOT zero. So 'compressor off' != 'zero current';
    it's a continuous baseload to budget; and it discriminates a fridge-in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
2026-08-11 fridge: record reverse-engineered compressor control model
    Add electrical.compressor_control_model: the P + I + Bias hypothesis for how
    the inverter regulates the fresh-food compartment, with the droop-cancellation
    reading (detect stabilization at setpoint+offset -> re-index bias table to
    setpoint-offset -> ramp bias to that colder speed; an event-triggered reset,
    size set by the table lookup).
    Worked example, 08-07 03:47 (run_auto_0802_1649.csv): current ramps ~845 ->
    ~912 mA; fitted FFC asymptote shifts 36.9F -> 35.4F (~1.4F colder), implying a
    ~36.2F setpoint and ~0.7F droop if the reflection is symmetric. Records the
    fit method + uncertainty (post asymptote is extrapolated).
    Documents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
2026-08-12 fridge: correct + expand compressor control model (FFC-only, cycling regime)
    FACT (Ron): the controller senses the FRESH-FOOD temp ONLY, not the freezer.
    Verified from ON/OFF edges: FFC is ~3x tighter than freezer (cut-out FFC std
    0.18F vs frz 0.61F; cut-in 0.51 vs 1.69). Corrects an earlier freezer-thermostat
    misread.
    New data-backed structure (kitchen_fridge_run.csv 2026-07-19):
    - Two regimes on the SAME FFC loop: continuous speed modulation at higher load
    (Aug), vs ON/OFF cycling at low load (Jul) when speed hits the min-speed floor.
    - FFC thermostat band (Jul): cut-out ~38.9F, cut-in ~40.1-40.5F (center ~39.5F,
    warmer than Aug ~36.2F -> likely a dial change).
    - min-speed-floor cutof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
2026-08-12 notebook: FFC compressor control law (P+Bias) + plot
    Identify the running-compressor law from kitchen_fridge_run.csv settled cycles:
    current ~= 784 + 31*(FFC-39.5) mA (Kp ~31 mA/F, Bias ~784 mA), fit RMS ~17 mA.
    Bias constant across settled cycles B/C/D; cutoff at ~765 mA / FFC ~38.9 F falls
    on the same line; Ki bounded as small. Pulldown cycle A runs ~200 mA above the
    law (higher bias; pre-A history unknown/messy). Adds analysis/ffc_control_law.png.
    Notes that this corrects the earlier bias-tracks-thermal-mass reading in
    kitchen_fridge.json (raw restart drop was mostly cut-in-FFC + restart boost);
    JSON still to be synced.
2026-08-12 fridge: replace wrong restart-current explanation with the measured equation
    Record the plain, dated result instead of the earlier interpretation: for the
    2026-07-19/20 settled running cycles, current = 784 + 31*(FFC-39.5) mA
    (fit RMS ~17 mA); same baseline each settled cycle; cut-off at ~765 mA / FFC
    ~38.9 F on the same line; pulldown cycle A runs ~200 mA higher (baseline not
    pinned, pre-A history unknown). Removes the earlier claim that restart current
    fell across cycles because the box kept getting colder -- that was the FFC value
    at restart plus a startup surge, not a falling baseline.
2026-09-12 firmware: move WiFi credentials into a git-ignored shared header
    The real SSID and password had been filled into esp32_rtd_wifi_test.ino in place of
    the placeholders. This repo has a GitHub remote, so a routine commit would have put
    them in the history permanently. They were never committed - caught before staging.
    Both WiFi sketches now include "../shared/wifi_secrets.h" (same relative-path pattern
    rotation_production.ino already uses for pins.h). That file is git-ignored;
    wifi_secrets_example.h is the committed template to copy from on a fresh clone.
    Also ignore data/*.ods - ~30 MB of binary spreadsheets derived from the raw captures,
    which the neighbouring *.csv / *.raw rules already ke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
2026-09-12 firmware: add esp32_rtd_wifi_node, the production RTD node
    Soldered perfboard node with TCP push, a phone-viewable page and local CSV backup.
    Identifies its access point by BSSID rather than channel (an earlier revision keyed
    off "gateway ch 6 / Buffalo ch 11" from docs/esp32_wifi_production.md and was wrong -
    both APs share one SSID and channels drift; a BSSID is a MAC and does not).
    TCP_PUSH ships disabled: with no listener on the far end, connect() blocks long
    enough to starve the sample loop - measured 2026-09-10 on the CF node at 41 samples
    and 1 persisted row in 122 s of uptime, where 1 Hz should give ~122 and 2. Re-enable
    it only alongside a listener, and give connect() an explicit s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
    [esp32_rtd_wifi_node.ino]
2026-09-12 tools: chart headroom, temps-over-current z-order, ac_power_log
    live_chart.py / scrub_chart.py: raise the temperature ceiling to 90 F and the current
    ceiling to 2500 mA - door-open transients and the fridge's 1.9 A defrost were running
    off the top of both scales. Draw the temperature axis above the current axis (with its
    patch hidden) so the noisy current band stops hiding the fridge temp.
    ac_power_log.py is new: it witnesses whether a commanded relay-open ACTUALLY cuts
    power, by logging the logging laptop's own AC/battery transitions from
    /sys/class/power_supply on the same box and clock as dual_logger. relay_cmd 1->0 with
    ac_online 1->0 = a real cut; relay_cmd 1->0 with ac_online still 1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
2026-09-12 docs/reference: index the inverter manual and resolve the thermostat's identity
    Renogy RNG-INVT-1000-12V-P2: the facts we actually lean on, quoted verbatim -
    neutral and ground bonded inside, yellow LED = GFCI / red = fault, the grounding
    recommendation, 8.7 A outlet rating.
    Thermostat: three numbers are attached to this unit and only SYSTXCCITC01-B is the
    model. A240356 / A170203 / A180218C are Carrier illustration numbers (A + 2-digit
    year + sequence) appearing throughout these books. The Owner's Manual cover shows a
    black and a white unit captioned with two of them, which reads as if the caption
    names the unit - it doesn't. Identification rests on the Carrier app.
    The installation instr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
2026-09-12 docs: outage runbook from the first real outage (2026-09-03/04)
    Written after the thunderstorm outage, at Ron's request, "so I don't forget to do
    things like this". Covers the first 30 minutes, the inverter-to-battery connection
    and car-loads-off checklist, FFC 5 as the outage setting, the rotation itself, SOC
    monitoring, known appliance behavior, the restore checklist, and the furnace.
    The headline number the project never had: SOC 85% -> 71% over 15.0 h on the 62.5 kWh
    pack is roughly 530 W total. The appliances are only ~75 W of that, so the LEAF idling
    is ~450 W and dominates everything - load-side optimization is nearly pointless, and
    the rule of thumb is ~1% SOC per hour, 2.5-3 days p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
2026-09-12 loads: correct the furnace bonding claim; record outage-measured freezer behavior
    FURNACE - inverter_compatibility.neutral_ground_bond_required was true, carrying a
    generic warning that flame rectification needs correct polarity AND a neutral-to-ground
    bond, and that a floating inverter output produces a 3-4 try lockout mimicking a gas
    fault. Wrong for this installation, twice over. The furnace has been run from the
    Renogy inverter repeatedly on line and neutral only, no green wire, and it lights,
    proves flame and heats the house: the rectification loop closes inside the furnace and
    needs neither the source's bond nor earth. And this inverter documents an INTERNAL
    neutral-ground bond, so the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
2026-09-12 tools: add cur_corruption_scan.py -- corrupt CUR lines bucketed by current level
    docs/todo.md asks for a corrupt-line RATE that can be compared before vs after one
    change, so "lower the baud" and "ferrite / re-route" can be told apart instead of
    guessed at. This produces it, and tests the standing hypothesis at the same time by
    bucketing the rate against the current in effect when each corrupt line arrived - on
    an inverter compressor, running current is a proxy for speed.
    Works off the .raw sidecar, which preserves the corrupt lines the hardened parser
    drops, each stamped with the logger machine's wall clock on arrival.
    Counts only data-shaped lines as corrupt. Banners, countdowns and "# .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
2026-09-12 docs: scope socket ingest for dual_logger (design only, not built)
    With no rotation there is no control path, so the Arduino only has to send. That
    removes the DTR-reset mechanism that kept the USB cable necessary, and both nodes can
    become one-way senders with dual_logger listening.
    The change is bounded: _serial_lines() already separates transport from parsing, so
    this is one new generator with the same contract. Regexes, merge, columns, status bits
    and file guards are untouched, and nodes keep sending the exact line format they send
    over serial today - which keeps .raw files comparable so cur_corruption_scan.py can
    measure before vs after.
    Records the guards that matter: coast control m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
2026-09-13 todo: settle kitchen_fridge_run2 (wrong channel, scrap) and retire a falsified hypothesis
    kitchen_fridge_run2.raw maxes out at 0.14 A across 23 h and 406,240 data lines - the
    noise floor of a channel with nothing on it. The fridge cycled normally throughout; the
    current channel was not watching the socket it was plugged into. Recorded so the file
    is not re-analyzed and the question is not re-asked.
    It does NOT affect rotation_budget.md: that doc's ~0.75 A / ~59-60% night duty comes
    from run_20260721_135703 (Jul 21-24, no relay control), which carries real current -
    2,673,800 rows, mean 0.689 A, max 2.571 A.
    The channel-targeting item stays open and is restated in the form that now matters: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
2026-09-14 docs: record the Jackery 300 Plus conversation + queue the mock-up
    Ron asked for this conversation to be documented before going back to soldering.
    Nothing in it is measured on the unit - specs are vendor pages, not the manual, and the
    model is not yet confirmed (the newer 300 v2 has a UPS bypass the Plus lacks, which
    would change the design). Marked as such throughout.
    Per-load verdicts against 300 W continuous / 600 W surge:
    - Kitchen fridge YES - worst case is the ~2 s defrost-entry overlap at ~276-300 VA,
    inside the surge rating, and no locked rotor.
    - Chest freezer NO on present evidence - its starting surge has never been measured
    (lessons.md #10) and the ceiling is only ~5.2 A a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
2026-09-14 hardware: record the ESP32 board selection and the perfboard node facts
    The temperature-rig section still described the breadboard build and said nothing about
    which board to pick in the Arduino IDE - which is exactly what Ron had to ask about
    mid-soldering.
    Board selection is WEMOS LOLIN32, recorded as what actually works rather than what the
    module marking implies: Ron flashed with it 2026-09-14 and the node runs and answers to
    cf.local. The module is a plain ESP32-WROOM-32 (HiLetGo), so ESP32 Dev Module is the
    other generic candidate, but there is no reason to change a selection that works.
    Also gathered the hard-won bits that were only in the lab notebook and sketch headers:
    lower the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
2026-09-14 hardware: correct the ESP32 upload-speed note
    Previous commit told the reader to lower the upload speed, generalising a single
    2026-08-01 failure into standing advice. Wrong: 921600 is what is set and it works -
    Ron flashed the new node with it 2026-09-14.
    Recorded correctly as a fallback: if an upload fails with a flash-comm / serial-noise
    error, lowering the speed and re-plugging USB has fixed it before. Don't lower it
    pre-emptively.
    Claude-Session: https://claude.ai/code/session_01W1W54auyWcS8PaETpNzcJQ
2026-09-14 hardware: buy ACS712 breakouts with mounting holes
    The boards on hand have no mounting holes, no room to drill any, and barely an edge to
    grip. Ron: mounting one is the job he dreads. A drilled variant exists - buy that one.
    Recorded alongside the reason to stay on the ACS712 anyway for new sensing points: same
    chain as the existing channels, so new data needs no cross-calibration before it can be
    compared with old. Also noted the in-line nature of the part, and that a split-core CT
    is not a drop-in alternative - it needs a line splitter to see a single conductor, and
    5-10 A or a 10x tap to have any resolution at ~0.7 A.
    Cl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
2026-09-15 docs: MCU inventory, board selections, and the sensing-node decision
    From a bench inventory while soldering the RTD nodes. Written down so it is not
    re-decided, and because one detail is genuinely dangerous to get wrong.
    THE DANGEROUS DETAIL: the relay startup order is OPPOSITE between the two AVR families
    now on the bench. lessons.md #1 is specifically about the ATmega4809 - digitalWrite
    before pinMode does not pre-set the latch there, UNLIKE classic AVR. So shared/
    safe_startup.h is correct for the 4809 boards (Uno WiFi Rev2, Nano Every) and WRONG for
    the 328P/32U4 boards (Nano, Uno R3, Yun), where pinMode-first drives the pin LOW =
    relay CLOSED. A three-line form correct on both families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
2026-09-15 docs: finish the MCU inventory - XIAO nRF52840, Parallax BOE, Gemma M0
    Completes the bench survey.
    XIAO nRF52840 (x2): BLE and NFC only, no WiFi, so not the radio half of the sensing
    node. Parked against a real future use instead - the house-temperature channel that
    todo.md's demand-aware dispatch section requires and that does not exist yet. That sensor
    belongs in living space where a wall wart is unwelcome, which is what these are built
    for. Flagged for the socket-ingest work: a BLE source would be a second transport
    alongside TCP, which that design does not currently anticipate.
    Parallax Board of Education: open which version. The BASIC Stamp carrier is out - no
    analog input, and PBASIC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
2026-09-20 tools: add airgradient_poll.py -- ambient over the local API, one clock
    Replaces manual batch downloads from the AirGradient cloud. The monitor
    (I-9PSL, fw 3.7.0, serial 3cdc75bc2990) serves current measurements over
    plain HTTP on the LAN with no token and no internet, so the feed survives
    an outage -- the monitor is on inverter-backed power with the modem.
    Meant to run on the Ubuntu box beside dual_logger.py: both stamp on
    arrival with that machine's wall clock, so ambient joins the merged
    capture on unix_s with no rate scaling and no phase alignment. Running it
    on a second machine would reintroduce the lesson #8 two-clock merge.
    Conventions carried over from dual_logger.py: full JSON mir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
    [airgradient_poll.py]
2026-09-20 docs: step-by-step build for the rig's D1 mini WiFi bridge
    Moving Ubuntu upstairs while the rig stays in the basement puts the current
    stream past passive USB's ~5 m, so WiFi stops being a preference. This is
    the build-and-bring-up procedure, written before the parts are on the bench
    so the traps are known in advance.
    Uses a separate D1 mini bridge rather than the Uno's own NINA radio, for
    the two reasons already in the repo: socket-ingest sec 9 records the
    WiFiNINA connect as unverified (and a blocking connect starved the RTD node
    to 41 samples in 122 s), and sec 10 warns about a transmitter inches from
    the ACS712 analog lines -- where hardware.md already has a CONFIRMED case
    of WiFi-TX sp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
2026-09-21 docs: record the assembled ESP32 + ACS712 + ADS1115 perfboard node
    Ron has a perfboard node built and populated except for the ADS1115:
    ESP32-WROOM-32 with OLED, ACS712, Adafruit BSS138 4-channel level
    converter, 7805 fed from a 9 V battery. It was built before this file's
    bench sweep and the sweep missed it, which is why sec 5 still reads the
    ADS1115 as a loose part.
    It changes what two sections conclude, so both now cross-reference it:
    - sec 4 rejected "ESP32 + a divider on the ACS712 output". That is about a
    DIVIDER and does not describe this board, which has none -- the ADS1115
    reads the sensor directly, which is the sec 5 differential-against-Vcc/2
    arrangement, electrically bett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
2026-09-21 docs: record the perfboard node board markings
    Module can reads ESP-32D / WiFi+BT / N4XX, matching the module already
    recorded in hardware.md for the RTD node -- so N4 = 4 MB flash and no
    PSRAM is now read off the part rather than inferred, which is what the
    GPIO16-is-free claim in sec 7 rests on.
    Carrier PCB is marked HW-724 front and back. That designator has no
    findable public documentation, so the board is identified by the
    combination of can marking, HW-724 and pin count, and the silkscreen --
    not an online diagram for a differently-named board -- is the authority
    for pin labels.
2026-09-21 docs: mark the perfboard node as not known to be finished
    Ron recalls building this on a breadboard and being interrupted part-way
    through moving it to perfboard -- the same motion hardware.md records for
    the RTD node. Nothing in the repo records either version, so the parts
    list in sec 7 is what is visible on the board, NOT a claim that the wiring
    is complete.
    As first written the section read as a finished board minus one part,
    which would invite powering it up on that assumption. The missing ADS1115
    may be where the work stopped rather than the only thing outstanding, so
    an absent connection must not be read as a design decision.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
2026-09-21 docs: survey 23 prior-art sketches, and confirm GPIO16 = ALERT/RDY
    23 Arduino sketches from Nov 2024 - Mar 2025 sit in the Mac's data dir one
    level above this repo, in no version control, predating the repo by about
    eighteen months. Several bear directly on work being designed right now.
    They are surveyed rather than copied in: 10 of the 23 have the live WiFi
    SSID and password hard-coded and this repo is public.
    GPIO16 in mcu_inventory sec 7 was recorded yesterday as PRESUMED ALERT/RDY.
    It is now CONFIRMED -- continuous_ADS1115 and
    running_statistics_socket_server_2 both declare `constexpr int READY_PIN =
    16;` under the comment "Pin connected to the ALERT/RDY signal for new
    sample notificat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
2026-09-21 docs: record the 2025 fan capture and what it says about the board
    Ron recalls the sec 7 perfboard node was built to measure SURGES, targets
    being the furnace blower and the compressors, and that he measured a large
    fan with it. That capture survives -- a 5426-sample CoolTerm log from
    2025-03-09 carrying the esp32_acs712_ads1115 banner.
    The chain worked: symmetric +/-8 A peak AC waveform. Three findings out of
    it, all blocking before the board can quote a number:
    - The measured zero is 2.27 V, not the 2.5 V every sketch subtracts, so
    everything that chain reported carries a systematic -2.3 A offset. 2.27 V
    also sits BELOW current_sense.h auto-zero window of 2.3-2.7 V, so lesson
    #4 wo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
2026-09-21 docs: the fan capture was the breadboard build, and the ADS1115 is not ratiometric
    Ron: the 2025-03-09 capture was probably made with the breadboard version,
    which no longer exists; the perfboard node "probably" has the same wiring.
    That is recollection, not verification, so it cannot validate the perfboard
    build -- and the 2.27 V zero must NOT be inherited. A zero belongs to a
    specific sensor on a specific supply. Re-measure on the finished board.
    What survives is architectural, and it is the more useful half. The ACS712
    zero is Vcc/2 by design, so 2.27 V implies a ~4.54 V sensor rail -- 230 mV
    is far outside ACS712 offset tolerance, so it reads as supply sag rather
    than a quirky part (rea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
2026-09-21 docs: settle why three MCU pins go to the level shifter
    From photos of the board and of the ADS1115 module, 2026-09-21.
    The module is the generic blue "16Bit I2C ADC+PGA" board, not Adafruit,
    and carries 10k (103) resistors on SCL, SDA, ADDR and ALRT. The ADS1115
    ALERT/RDY output is OPEN-DRAIN, so it needs that pull-up to work at all --
    and the pull-up goes to VDD. With the ADS1115 at 5 V, ALRT idles at 5 V,
    which must not reach a 3.3 V ESP32 input.
    So the three shifted lines are SDA (5), SCL (4) and ALRT (16) -- three
    channels of the four-channel BSS138 board. The design is coherent, and it
    confirms the intent of a 5 V ADS1115: at 3.3 V none of the three would
    need shifting. ALERT/RDY bei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
2026-09-21 docs: level shifter IS installed; sort the Dupont question by failure mode
    A second photo shows the 4-channel bi-directional level shifter socketed on
    the upper board, directly below where the ADS1115 socket will go -- it was
    simply hidden at the first camera angle. Check clearance before soldering
    that socket.
    Ron flagged the Dupont inter-board jumpers as working against the reason
    for moving to perfboard, and the instinct is right: crimped Dupont sockets
    are the same class of failure as the breadboard contacts hardware.md
    records at ~1-2 faults per thousands of samples.
    But two connections are legitimately pluggable -- the ESP32 MUST stay
    socketed (strapping pins GPIO 2/12/15 are shared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
2026-09-23 docs: bring-up checklist for the ESP32 + ADS1115 board
    The digital path (VDD, GND, SCL, SDA, ADDR, ALRT) is wired and the analog
    inputs are not, which is the right split: a failure now has exactly one
    place to be -- the shifter, its references, or a pull-up.
    Four phases, each with an abort condition. The one that matters most is
    Phase A on the shifter socket: if LV and HV are transposed, the "3.3 V
    side" carries 5 V straight into GPIO 16/5/4, which is the only mistake on
    this board that kills the ESP32 instantly. Phase C catches it too -- 5 V on
    any of those GPIOs means power off now.
    IDE settings recorded: WEMOS LOLIN32 at 921600, per hardware.md and
    confirmed on a module with these exact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
2026-09-23 docs: the differential mode WORKED, and per-power-cycle stats was the goal
    Corrected from Ron contemporaneous notes (notes.odt / notes2.odt /
    Untitled 6.odt, same text in all three, found 2026-09-23).
    I had recorded differential AIN2/AIN3 as "written, then parked". It ran:
    MUX_DIFF_2_3, CONTINUOUS, RATE_ADS1115_860SPS, validated against a signal
    generator at 60 Hz / 1 VAC rms / 0 VDC in Dec 2024. Caveat on what that
    proves: 0 VDC offset means the generator drove the ADC inputs directly,
    not through the ACS712, so the sensor-to-ADC arrangement is still
    unproven. Why the Feb 2025 sketch switched back to MUX_SINGLE_0 is
    unrecorded -- do not read the comment-out as evidence differential failed.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
2026-09-23 docs: bring-up results -- rail is 4.81 V, so the zero is 2.405 V
    All digital checks passed 2026-09-23 with the analog inputs still unwired.
    i2c_scanner finds 0x3C and 0x48; the ALRT interrupt fires; A0 reads 0.00 V
    tied to GND and 4.8 V tied to VDD at GAIN_TWOTHIRDS, against 4.81 V on the
    meter.
    Two things are proven harder than they look. The scan finding both
    addresses means the shifter passes SDA/SCL BIDIRECTIONALLY -- an ACK
    requires the slave to pull SDA low and that pull to come back through the
    shifter. And continuous_ADS1115 prints only when its ISR sets new_data, so
    output at all proves shifter channel 1 (ALRT) works.
    The ADS1115 internal reference is trustworthy to ~0.2
2026-09-23 docs: record the 7.5 V wall wart, and that being unregulated inverts the tradeoff
    Ron found a 7.5 V / 700 mA UL-listed wall wart whose connector already
    mates the 7805 input on this board; with USB disconnected, 5 V and 3.3 V
    appear where expected. It supersedes the 9 V battery as the deployment
    supply. Recorded now because he is mid-task, before soldering the analog
    inputs.
    It is UNREGULATED, which corrects something I said in conversation. An
    unregulated wart is rated at FULL LOAD -- 7.5 V at 700 mA, rising as load
    falls -- and this board draws well under that, so the real input is likely
    9-10 V or more. My earlier "7.5 V dissipates ~38 percent less than the 9 V
    battery" assumed 7.5 V act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
2026-09-23 docs: confirm the wall wart's DC label, and flag regulated-vs-unregulated as unverified
    Label reads 7.5VDC 700mA, model PSA12D7P5P7-A, "ITE POWER SUPPLY", UL,
    made in Taiwan; sold as a Belkin router replacement. DC output is now
    confirmed from the label rather than inferred from the board working --
    worth checking, because some retail listings for this same model describe
    it as AC/AC, and an AC-output wart feeding a 7805 would drive the
    regulator's input negative every half-cycle, outside its ratings.
    Separately, marked the regulated/unregulated question as UNVERIFIED. It
    was recorded as unregulated on Ron's word without a stated basis, and the
    whole rest of that section depends on it. The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
2026-09-23 docs: wall wart confirmed unregulated at 11.7 V open circuit
    11.7 V open circuit against a 7.5 V rating -- a 56% rise, textbook
    transformer-plus-rectifier. So the unregulated analysis stands and the
    regulated caveat is removed.
    Two consequences sharpened:
    - A heatsink is effectively REQUIRED, not advisable. At this board's light
    load the input will sit near 9.5-10.5 V, so the 7805 burns ~1.25 W at
    250 mA and over 2 W on WiFi peaks. A bare TO-220 at 1.25 W runs ~75 C
    above ambient. This is MORE dissipation than the 9 V battery produced.
    - A better wall wart is probably already in Ron's pile of ~20. Now that
    open-circuit voltage is measurable, the selection rule is concrete: take
    t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
2026-09-23 docs: record the supplies on hand and what to bring up on
    Ron has ~20 wall warts but no other candidates -- all lower voltage than
    the 7805's ~7 V input requirement -- plus 19.5 V Dell laptop supplies and
    two lab supplies.
    The Dell supplies are NOT usable through the 7805: (19.5-5) x I is ~3.6 W
    at 250 mA and over 7 W on peaks, which is thermally impossible for a TO-220
    rather than merely needing a heatsink. They would only serve ahead of a
    switching converter this build does not need.
    Bench bring-up should use a lab supply at 7.5 V into the 7805 input. Beyond
    the heat saving it removes two confounds at once (regulated, so no 120 Hz
    ripple and no burst-correlated rail movement while charac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
2026-09-23 docs: decided -- the surge board runs from a lab supply
    Ron expects to use this board a few times rather than deploy it, so it
    runs from a lab supply: 7.5 V into the JST, ~400 mA limit for the first
    power-up after the analog inputs are soldered.
    That closes a whole branch of open questions in this section -- no wall
    wart, no barrel-to-JST adapter, no center-negative polarity hazard (guitar
    pedal supplies are center-negative by convention and this board has no
    protection diode), no 120 Hz ripple, and the 7805's heat is supervised
    rather than unattended. The supply survey is retained but re-headed as
    applying only to a possible unattended deployment.
    Two consequences kept: the rail still set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
2026-09-24 docs: analog wired and calibrated; sensitivity confirmed ratiometric to Vcc
    Bench session 2026-09-24. ACS712 OUT to A0 and A2, 1k/1k from the 7805's
    output to A3 with 0.1 uF, running MUX_DIFF_2_3 continuous at 860 SPS on
    GAIN_TWO (+/-2.048 V, matching the ACS712-20A's own span, 0.625 mA/bit).
    Measured: 12.24 mV at 0 A, 59.38 mV at 0.500 A, and 211.95 / 212.71 mV on
    two runs at 2.00 A. Noise is ~3.4 mA RMS and independent of signal level.
    The residual zero of 122 mA is stable and subtracts out; divider resistor
    tolerance is likely most of it.
    Two findings worth the write-up.
    It is NOT one straight line. Implied slopes are 94.3 mV/A over 0-0.5 A but
    101.7 over 0.5-2.0 A, so a fit anchored a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
2026-09-25 firmware: per-power-cycle statistics for the ADS1115 surge node
    One line per 60 Hz cycle -- mean, RMS about the mean, and peak deviation --
    from the ESP32 + ADS1115 + ACS712 perfboard node.
    This is the architecture Ron's own Dec-2024/Jan-2025 notes set as the goal
    and that none of the 2024-25 sketches reached: "If 60 Hz sample, output
    stats for this 60 Hz cycle, reset stats". What shipped instead averaged
    ~10 cycles into a 167 ms window, which is exactly what hides a start
    transient. Per-cycle numbers give the envelope of a surge cycle by cycle.
    The mean is the LIVE ZERO: over a whole cycle of AC the average is the
    offset, so nothing is hard-coded and supply drift self-corrects. That is
    th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
    [esp32_ads1115_cycle_stats.ino]
2026-09-25 docs: per-cycle firmware running, and the offset drift it exposed
    First run of firmware/esp32_ads1115_cycle_stats confirmed the mechanics:
    window deltas average 16.67 ms with no drift, n alternates 14/15 matching
    860/60 = 14.33 samples per cycle, and at 2.00 A DC the current landed
    entirely in dc_a while rms_a stayed at the noise floor.
    After ~92 minutes the zero read 12.19 mV against the 13.08 mV calibration
    constant -- a 0.89 mV drift, exactly the -9 mA dc_a then reports at zero
    current. Comparing against the same session's 2.00 A point identifies which
    parameter moved:
    - NOT ratiometric this time. Pure Vcc scaling needs k = 0.932 to explain
    the zero but k = 0.994 to explain the 2 A po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
2026-09-27 loads: the chest freezer's inrush is MEASURED -- 17.8 A peak, 11.75 A for ~1.1 s
    Captured 2026-09-27 with firmware/esp32_ads1115_cycle_stats at ~881 SPS,
    per-power-cycle statistics. Two starts in one capture: a forced restart
    after 4 minutes off, and a natural thermostat start after 35 minutes off.
    This closes the open item lessons.md #10 has carried since the beginning.
    The old 3.5 A figure was method-limited by the 10 Hz / 100 ms-RMS chain and
    understated the start by 5x on peak and 3.4x on RMS. It is retained as
    superseded_inrush_peak_a so older analyses stay traceable. "Likely much
    higher" was right.
    Two fields that were null are now resolved:
    - plateau_a = 11.75 A. The signature RESO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
2026-09-27 correct 0f0d6c9: the rig DID record the surge -- 3.5 A was an analysis artifact
    I recorded this morning that the 10 Hz chain understated the freezer's
    start by 5x on peak. That is wrong, and re-reading the source capture
    shows why.
    latest_chest_freezer_run.csv contains a maximum of 12.128 A, which agrees
    with the new instrument's 11.75 A RMS to within 3%. The 3.5 A figure in
    chest_freezer.json does not reproduce from its own stated derivation ("max
    of first-3s samples across run starts") -- recomputing exactly that from
    exactly that file gives 12.128 A. So it was an ANALYSIS artifact, not a
    measurement limit.
    Lesson #10's stated mechanism is also wrong in its specifics: the transient
    is no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
2026-09-28 record the 2026-09-27 freezer session: 4 clean starts, 2 clean cycles, and a new lesson
    INRUSH (stands, strengthened): four clean starts rather than two --
    17.07 A forced, then 17.81, 17.67 and 17.24 A on natural thermostat
    starts. Peak spread 4%, locked-rotor RMS 11.54-12.02 A, locked-rotor
    duration 1.07-1.10 s on all three natural starts. Each was verified
    gap-free across its first 2.5 s.
    CYCLES (weak, and recorded as such): only two of five are usable --
    34.66 min from a forced start, and 52.45 min after 35.2 min off, giving one
    duty figure of 59.8%. Both far exceed the 26.6 min mean run already on
    record, but two cycles from a session that opened with two deliberate power
    interruptions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
2026-09-28 loads: deployment duty is 60.8%, not 70% -- the defrost experiment's BEFORE capture
    A gap-free 13.2 h capture in the deployment location, undisturbed, 9
    complete cycles, 2.84M rows (overnight_freezer_capture.txt). This is the
    BEFORE half of the defrost experiment queued in todo.md.
    on 52.30 min sd 2.08 (8 normal runs)
    off 33.80 min sd 0.15 -- nine seconds across 8 intervals
    duty 60.8% sd 0.9 [warm-bench characterisation: 70%]
    The repeatability is the striking part: an off period reproducible to nine
    seconds, and inrush reproducible to 0.7% on the locked-rotor RMS.
    It differs sharply from the warm-bench figures -- on 52.3 vs 26.6 min, off
    33.8 vs 11.1, cycle 86 vs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
2026-09-29 loads: fridge measured -- crest factor as a load signature, and a full defrost
    A gap-free 17.6 h capture, 3.79M rows, 17 cycles, one complete defrost
    (fridgeCapture.txt), with firmware/esp32_ads1115_cycle_stats at 60
    windows/s.
    CREST FACTOR IS THE NEW MEASUREMENT and the rig cannot make it.
    Compressor 2.68 across 16 separate runs; defrost heater 1.41, against a
    resistive reference of 1.4125 and sqrt(2) = 1.4142. So the heater is a
    textbook resistive load and the compressor is a rectifier front end drawing
    current in short peaks near the voltage crest. That independently
    corroborates the PF ~0.55 estimate -- crest factor 2.7 and PF 0.55 are the
    same phenomenon seen two ways -- and it means t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
2026-09-29 loads: the defrost "dips" were real but over-generalised -- 1 defrost in 6
    Ron did not recognise the claim that the defrost heater shows periodic dips
    to ~1 A, and asked how a resistor could do that. Tracing it:
    The observation is genuine. run_20260721_135703.csv on the Ubuntu box --
    a capture the provenance.capture_files list never recorded, which is why it
    took digging -- contains the 07-21 14:24 defrost with two samples at
    exactly 1.000 A, at t+15.8 and t+25.9 min, 10.1 min apart. That matches the
    original note precisely.
    But the same file holds four more defrosts, and all four contain ZERO
    samples below 1.5 A. The 2026-09-28 defrost measured at 60 windows/s -- about
    3500x the temporal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
2026-09-29 loads: record the anatomy of the defrost dips, and why rarity does not settle it
    Following Ron's questions about duration and within-dip variation.
    Each dip is ten rows at exactly 1.000 A, which is ONE underlying
    measurement repeated ten times by dual_logger's sample-and-hold. The true
    event duration is unknown and bounded only by the Arduino's 100 ms RMS
    window -- the apparent 1.0 s belongs to the logger, not the fridge. There
    is no within-dip variation to examine because there is only one
    measurement.
    It is not ordinary noise: consecutive distinct samples during normal
    heating vary by ~10 mA, and the dip differs from its neighbours by 840 mA,
    about 84x that scatter.
    Left explicitly UNRE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
2026-09-29 docs: Jackery model confirmed -- Explorer 300 Plus, no UPS bypass
    Open since 2026-09-14. Ron confirms the 300 Plus, not the v2.
    The consequence is not what this doc assumed. It supposed a v2 would make
    the buffer idea "easier, not harder" because of its ~20 ms UPS bypass. In
    fact the absence of bypass HELPS the seamlessness requirement: with the
    output always inverter-generated there is no transfer at all when the rig
    opens the relay, so the fridge sees nothing, not even 20 ms.
    What it costs instead is continuous conversion loss, since the fridge's
    power passes through the inverter even while the wall is feeding it.
    Round-trip on a time-shifted watt-hour is likely 80-85%, so the ~26 W
    aver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
2026-09-29 docs+tools: Jackery buffer mock-up procedure, and a serial logger for the Ubuntu box
    The experiment todo.md queued 2026-09-14 and left open on "decide WHAT to
    record". Settled now that the instrument exists.
    The measurement conflict todo.md flagged -- behind a battery the rig's
    channel sees charging rather than the compressor -- is resolved by
    measuring BOTH sides at once: the rig's ~1 Hz chain on the charging side,
    where a slow steady load is exactly what it does well, and the 60
    windows/s instrument on the fridge. The rig's weakness is fast transients
    and there are none on the charging side.
    Four questions it answers: the Jackery's AC charging rate and profile (the
    number the duty-cycle-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
    [serial_capture.py]
2026-09-29 docs: the Jackery buffer mock-up, measured
    Ran the experiment sec 7 left open: fridge on Jackery battery alone, grid
    power, no inverter, no rotation, current measured at 60 windows/s. A
    defrost fired during the run, so it became the worst case the buffer would
    face rather than the steady-state test intended -- more useful than
    planned.
    The fridge runs normally behind it: crest factor 2.73-2.76 on the Jackery
    against 2.68 on wall power, same sensor minutes apart. A 300 W portable
    inverter handles a load drawing 2.7x its RMS in peak current without
    visible distress.
    Discharge measured at two load levels: 1.41 %/min under the defrost heater
    (187 VA, 77% efficiency) and 0.48 %/min in recovery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
2026-09-29 docs: the Jackery has an internal fan -- airflow direction, and a caveat on "stayed cool"
    Ron established the airflow with tissue paper, since the unit sits on a
    running fridge where neither sound nor vibration is trustworthy: IN the
    left (larger) vent, OUT the right (smaller, where the AC input is).
    Recorded because sec 1 carries the vendor's heat caution without saying how
    the unit manages itself. Practical consequence: an external fan must assist
    that flow, never oppose it. Blowing into the right exhaust would fight the
    internal fan and could be worse than no fan.
    Also corrected an overstatement in the thermal note I wrote an hour ago.
    The "stayed cool at 276 W" reading was taken with a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
2026-09-29 correct: Jackery output IS 60 Hz, and the fridge's PF is ~0.78 not ~0.55
    Two corrections from the Jackery's own screen.
    FREQUENCY RESOLVED. The screen reads 120V 60Hz with the charger unplugged
    (its output) and 124V 60Hz with the charger in (the wall input). So the
    DMM's 80-90 Hz was a counter artifact as suspected, while its voltage was
    right. Per-cycle framing of this run's data is valid after all, and the
    chest freezer's induction motor would see a correct 60 Hz if ever put on
    the Jackery.
    POWER FACTOR. I recorded in kitchen_fridge.json that crest factor 2.68
    "CORROBORATES the PF ~0.55 estimate -- the same phenomenon seen two ways".
    That was overstated. Crest factor constrains power fac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
2026-09-29 docs: both screen readings are OUTPUT -- it rises to 124 V while charging
    I recorded the 124V 60Hz reading as the wall input. The manual labels that
    field "Output Voltage and Frequency", so both readings are the output: 120 V
    on battery alone, 124 V while charging.
    That is a behaviour worth knowing rather than a bookkeeping fix -- the
    inverter runs ~4 V higher when the charger is connected, presumably off a
    higher DC bus. VA arithmetic should use 124 V during charging and 120 V on
    battery.
    It shifts the power-factor readings slightly (the charging-period one
    becomes 0.753 A x 124 V = 93 VA against 70 W, PF 0.75) without changing the
    conclusion: ~0.75-0.89, not the ~0.55 on record.
    Co-Auth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
2026-09-30 docs: camera route for Jackery SOC -- screen timeout is settable, plus prior art
    The app exposes a Screen setting of 2 hr / 2 m / Off, which is what makes a
    camera practical: the one working prior art (philippbussche/jacktessery, an
    Explorer 1000 Pro) had to glue a robot finger to the output button to beat a
    2-minute timeout and got two readings a day.
    Recorded from reading that repo:
    - Its pipeline is Pillow only, ~25 lines, no OpenCV and no ML.
    - Tesseract DOES read seven-segment digits given lang=ssd_alphanum_plus and
    --psm 8. An earlier claim in conversation that Tesseract is wrong for this
    was too broad; it is wrong only without the seven-segment model.
    - The validation layer (max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
2026-09-30 docs: 0 W input was a dead power strip socket, not a Battery Save deadband
    Nearly recorded a charge-controller deadband off a symptom that was a bad
    outlet. Moving the plug one socket over brought input to 207 W and SOC began
    climbing. "Holds at 85% on pass-through" (section 9) stands unchanged.
    Added as lessons.md #12, because the failure imitates a real finding and the
    same strip also feeds the instrument, where it would produce the silent
    capture gap of #11 with an identical signature.
    Also recorded: the Jackery app is a dead control path today -- every attempt
    times out on "connecting Bluetooth" with no data and inert controls, while the
    unit answers ping on the LAN. Ruled out unit asl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
2026-09-30 correct: the 0 W-input test was confounded -- deadband vs dead socket is OPEN
    Ron caught it. Moving the charger to another socket and seeing charging start
    does not show the first socket was dead: re-plugging is itself an event that
    restarts charging logic, so a Battery Save deadband with a resume point near
    80% predicts exactly the same observation. Both hypotheses remain live.
    The discriminating test does not involve the Jackery at all -- put a known
    load in the ORIGINAL socket.
    Recorded weak supporting arithmetic for the deadband being absent (at ~74 W the
    pack falls 25-29%/h, so an 80-85% deadband would cycle every ~20-30 min and
    would be found below 85% most of the time, yet every ear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
2026-10-04 Ammeter: recalibrate at 5.012 V rail, add calibration procedure
2026-10-04 RTD node: document 0x1C fault family as supply, not probes
2026-10-04 Chest freezer: Kill A Watt energy, power factor, corrected run-current trend
2026-10-04 Jackery: sections 11-13, display reader split-out, power strip load item, reference docs
2026-10-07 Jackery: charging resumes at 80%, seen by the display reader camera
2026-10-12 Jackery: manufacturer FAQ corrections; fridge average 45 W; fridge rides through switch to battery
    Section 14: Jackery's FAQ for the 300 Plus (max AC input 200 W +/- 20 W; a transfer to
    battery "within 20 ms"; energy saving mode and auto-shutdown; radio re-enable from buttons).
    Section 15: 11 days on the KETOTEK give the fridge a 45 W average (1.08 kWh/day), so the
    202 Wh window carries it ~3.8 h, not ~6 h. Pulling the Jackery's input during a defrost and
    during a compressor run did not interrupt the fridge; output went 124 V -> 120 V -> 124 V.
    Charging resumed about a minute after input was restored.
    The "no bypass" statements in the header, section 1 and the mock-up procedure now point t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
